linguini1/pygmy/ground-station/enclosure/assembly.FCStd

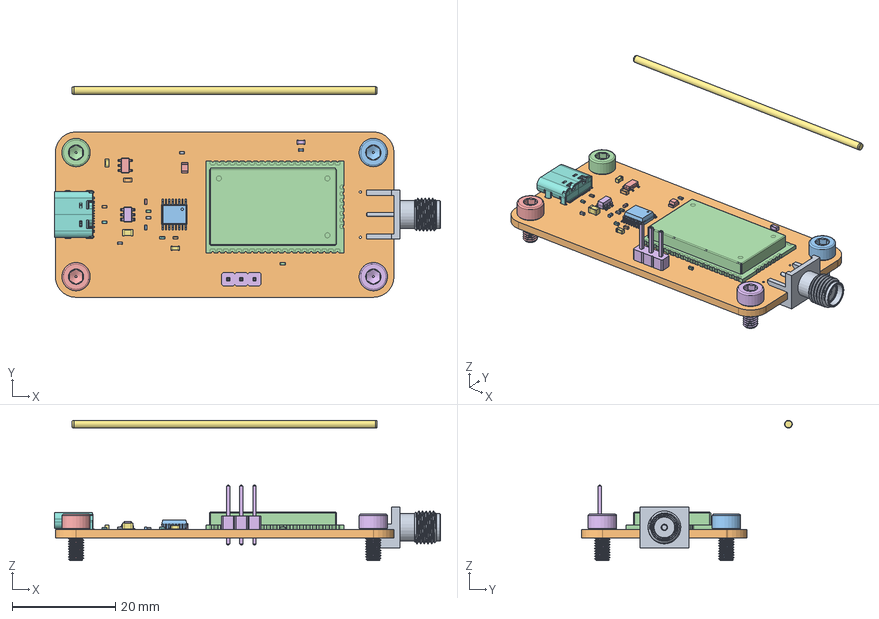
[picture p9: CAD file, 2025-03-23]
ground-station/enclosure/assembly.FCStd
74.7 x 40.7 x 27.1 mm
R_0402_1005Metric
C_0402_1005Metric
C_0402_1005Metric002
C_0402_1005Metric004
TSOT_23_5
C_0603_1608Metric
C_0603_1608Metric002
C_0402_1005Metric006
R_0402_1005Metric002
R_0402_1005Metric004
C_0402_1005Metric008
RN2483-I_RM095
LED_0805_2012Metric
PinHeader_1x03_P254mm_Vertical
C_0603_1608Metric004
R_0402_1005Metric006
SMA_Molex_73251-1153_EdgeMount_Horizontal
C_0603_1608Metric006
SSOP_16_39x49mm_P0635mm
R_0402_1005Metric008
C_0402_1005Metric010
SOT_23_6
L_0805_2012Metric
USB_C_Receptacle_16P_TopMnt_Horizontal_GCT_USB4105-xx-A
C_0402_1005Metric012
ground-station_PCB
M3x6-Screw
M3x6-Screw012
M3x6-Screw013
M3x6-Screw014
1.5 mmx59-Pin
