linguini1/pygmy/flight-computer/enclosure/assembly.FCStd

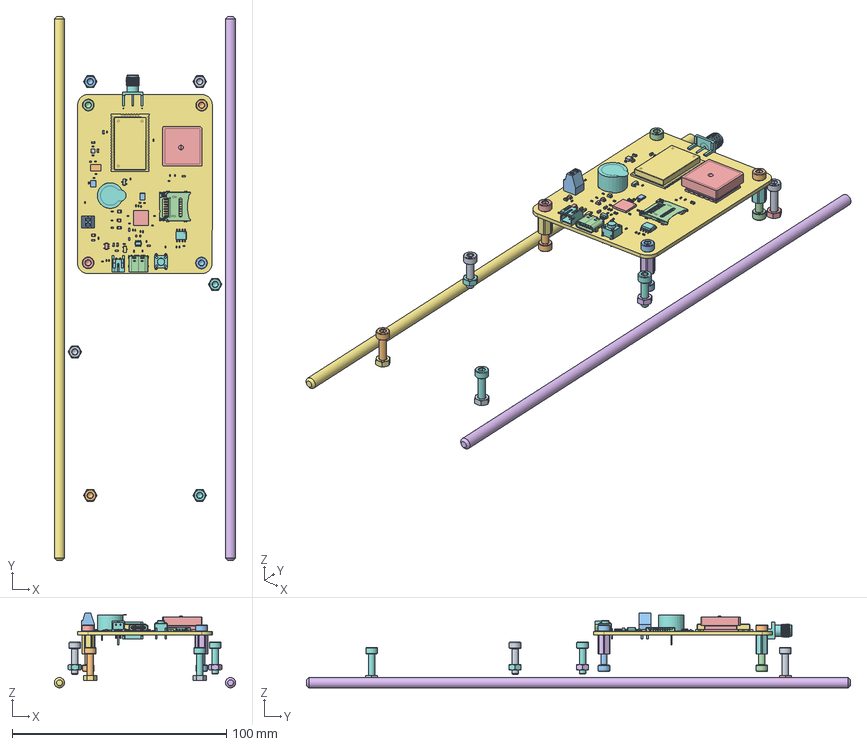
[picture p10: CAD file, 2025-01-09]
flight-computer/enclosure/assembly.FCStd
84.7 x 254.0 x 34.9 mm
C_0603_1608Metric
LED_0805_2012Metric
R_0402_1005Metric
C_0402_1005Metric
LC86G
C_0603_1608Metric002
C_0402_1005Metric002
SMA_Molex_73251-1153_EdgeMount_Horizontal
R_0402_1005Metric002
R_0402_1005Metric004
R_0402_1005Metric006
C_0402_1005Metric004
LED_0805_2012Metric002
C_0402_1005Metric006
SOT-23-3
C_0402_1005Metric008
R_0402_1005Metric008
C_0402_1005Metric010
C_0402_1005Metric012
C_0402_1005Metric014
C_0402_1005Metric016
C_0402_1005Metric018
C_0402_1005Metric020
JST_S2B_PH_K
C_0402_1005Metric022
C_0603_1608Metric004
LSM6DSO32TR
USB_C_Receptacle_16P_TopMnt_Horizontal_GCT_USB4105-xx-A
R_0402_1005Metric010
C_0603_1608Metric006
RN2483-I_RM095
C_0603_1608Metric008
R_0402_1005Metric012
C_0402_1005Metric024
C_0402_1005Metric026
LED_0805_2012Metric004
TSOT_23_5
C_0402_1005Metric028
C_0603_1608Metric010
SOIC_8_39x49mm_P127mm
R_0402_1005Metric014
C_0402_1005Metric030
C_0402_1005Metric032
MEM2067-02-180-00-A
QFN_56_1EP_7x7mm_P04mm_EP32x32mm
LED_0805_2012Metric006
R_0402_1005Metric016
R_0402_1005Metric018
LGA_12_2x2mm_P05mm
R_0402_1005Metric020
R_0402_1005Metric022
C_0402_1005Metric034
C_0603_1608Metric012
R_0402_1005Metric024
R_0402_1005Metric026
SOT_23_6
C_0603_1608Metric014
R_0402_1005Metric028
C_0603_1608Metric016
C_0603_1608Metric018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
