linguini1/pygmy/flight-computer/buzzer/AI-1223-TWT-3V-2-R.step

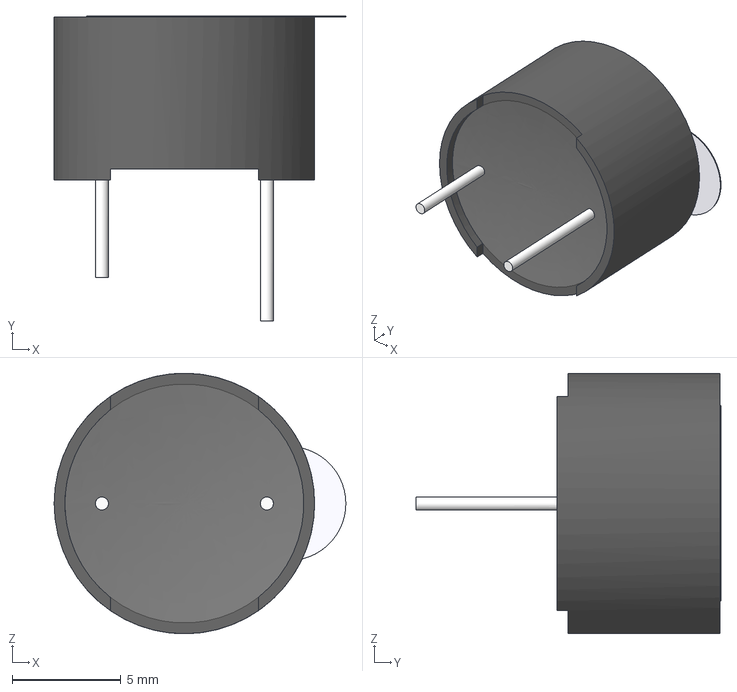
[picture p11: CAD file, 2024-11-21]
flight-computer/buzzer/AI-1223-TWT-3V-2-R.step
13.4 x 14.1 x 12.0 mm
