linguini1/pygmy/flight-computer/enclosure/enclosure.FCStd

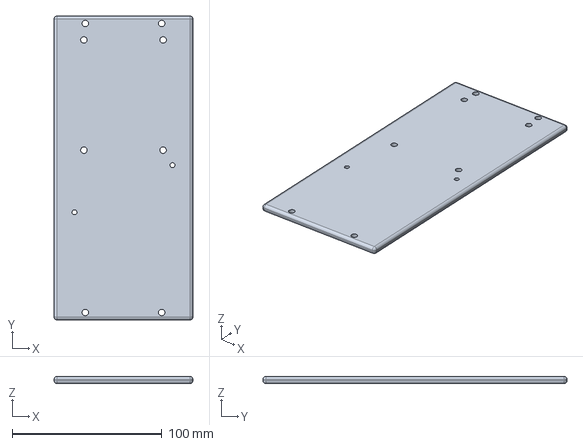
[picture p12: CAD file, 2025-01-09]
flight-computer/enclosure/enclosure.FCStd
92.7 x 203.2 x 5.00 mm
