linguini1/pygmy/flight-computer/lsm6dso32/LSM6DSO32TR.step

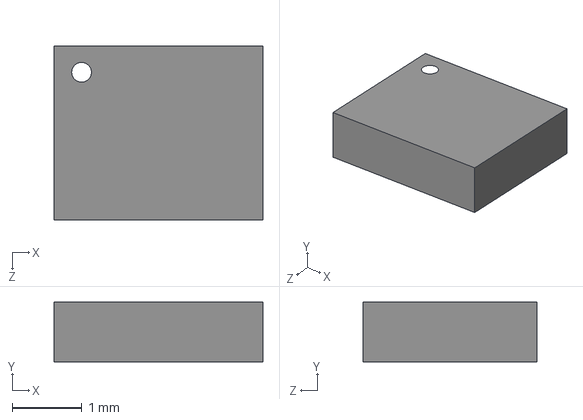
[picture p13: CAD file, 2024-11-11]
flight-computer/lsm6dso32/LSM6DSO32TR.step
3.00 x 0.86 x 2.50 mm
