linguini1/pygmy/flight-computer/microsd/MEM2067-02-180-00-A_REVB.step

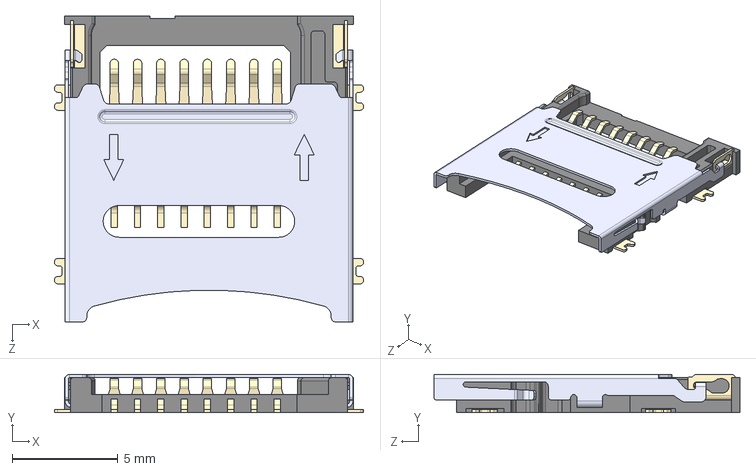
[picture p14: CAD file, 2024-11-11]
flight-computer/microsd/MEM2067-02-180-00-A_REVB.step
14.6 x 1.80 x 14.5 mm
