linguini1/pygmy/ground-station/enclosure/enclosure.FCStd

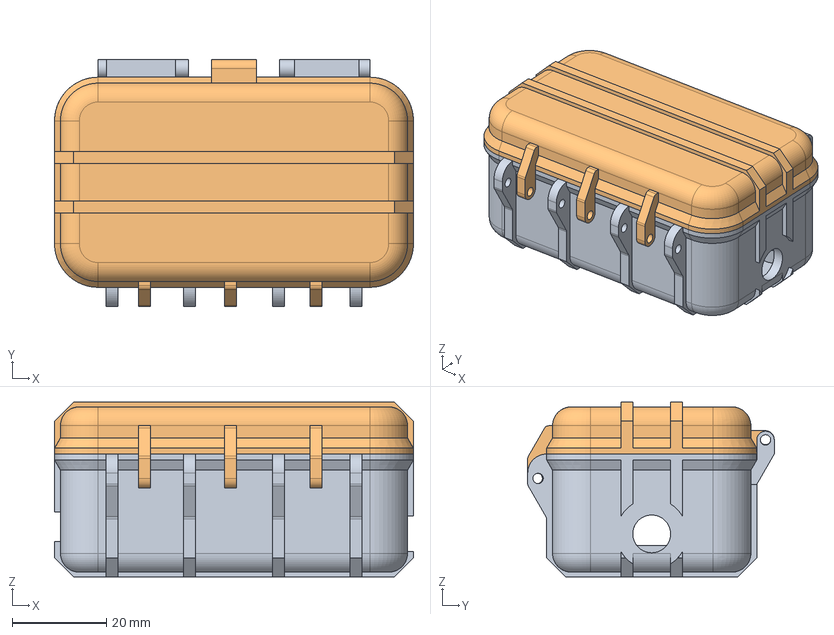
[picture p15: CAD file, 2025-03-23]
ground-station/enclosure/enclosure.FCStd
76.0 x 52.2 x 37.0 mm
Bottom
Top
