linguini1/pygmy/ground-station/enclosure/ground-station.step

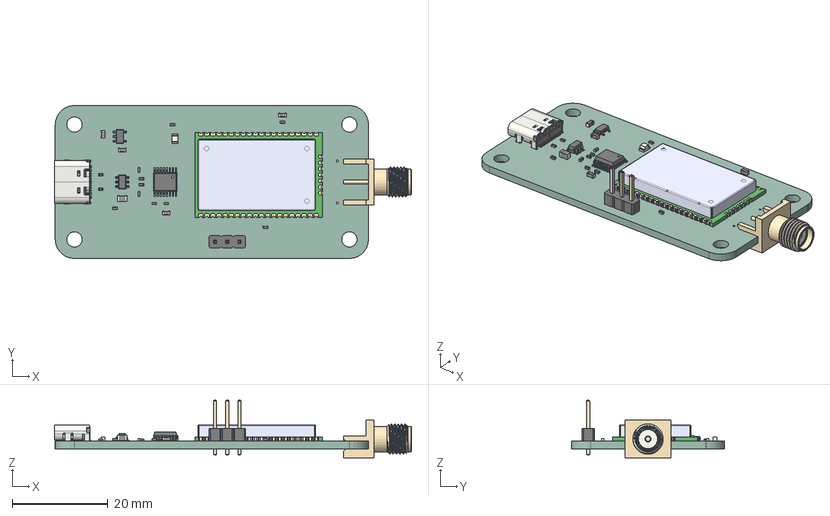
[picture p16: CAD file, 2025-01-08]
ground-station/enclosure/ground-station.step
74.7 x 32.0 x 12.1 mm
R_0402_1005Metric x 5
C_0402_1005Metric x 7
TSOT_23_5
C_0603_1608Metric x 4
RN2483-I_RM095
LED_0805_2012Metric
PinHeader_1x03_P254mm_Vertical
SMA_Molex_73251-1153_EdgeMount_Horizontal
SSOP_16_39x49mm_P0635mm
SOT_23_6
L_0805_2012Metric
USB_C_Receptacle_16P_TopMnt_Horizontal_GCT_USB4105-xx-A
ground-station_PCB
