linguini1/pygmy/flight-computer/minifit-jr/1726480102.step

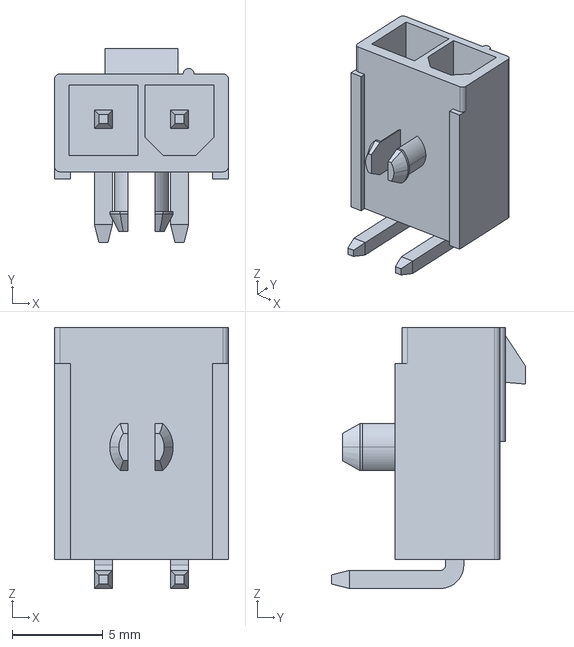
[picture p17: CAD file, 2024-11-11]
flight-computer/minifit-jr/1726480102.step
9.60 x 10.7 x 14.4 mm
