linguini1/pygmy/flight-computer/TODO.txt

Changes:
- More reasonable dimensioning of the board edges, currently slightly weird measurements for hole spacing
- Silkscreen to show direction of IMU & magnetometer axes

Nice to haves:
- Deployment terminal block with MOSFET connection to MCU
