linguini1/pygmy/flight-computer/flight-computer.kicad_pcb

## KiCad design flight-computer/flight-computer.kicad_pcb (2025-01-12)

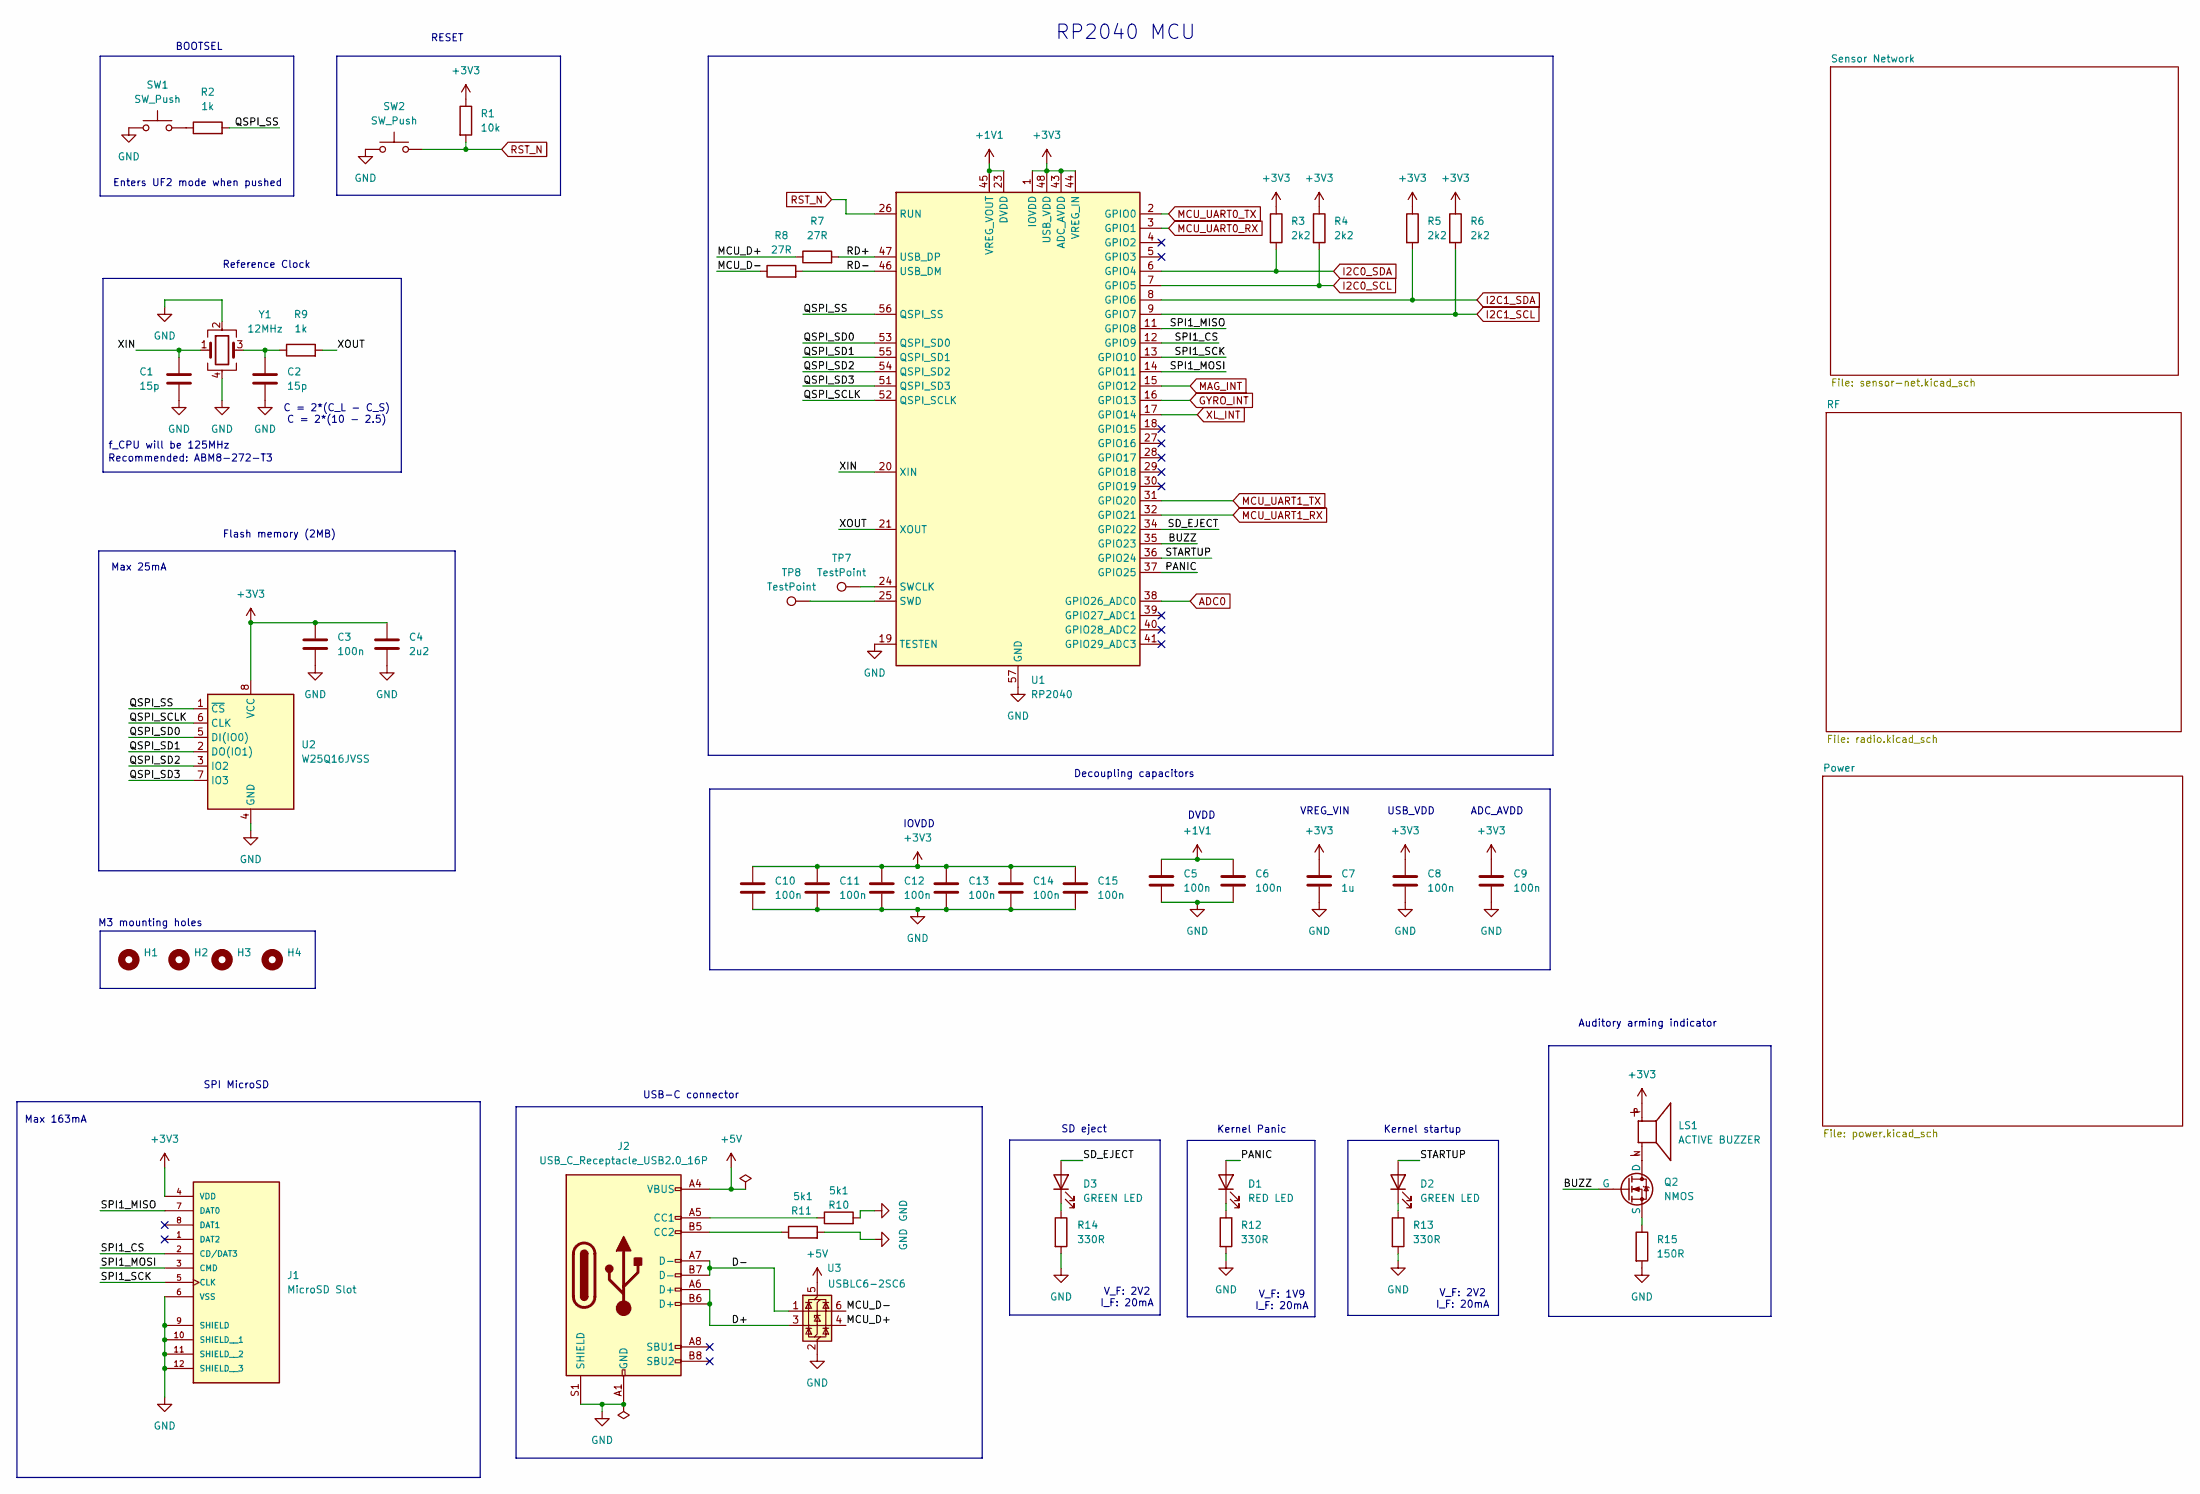
[picture p18: schematic flight-computer.kicad_sch, Pygmy]

Parts:
C1, C2: 15p; C_0402_1005Metric
C3, C5, C6, C8, C9, C10, C11, C12, C13, C14, C15: 100n; C_0402_1005Metric
C4: 2u2; C_0603_1608Metric
C7: 1u; C_0603_1608Metric
D1: RED LED; LED_0805_2012Metric
D2, D3: GREEN LED; LED_0805_2012Metric
H1, H2, H3, H4: MountingHole; MountingHole_3.2mm_M3
J1: MicroSD Slot; GCT_MEM2067-02-180-00-A_REVB
J2: USB_C_Receptacle_USB2.0_16P; USB_C_Receptacle_GCT_USB4105-xx-A_16P_TopMnt_Horizontal
LS1: ACTIVE BUZZER; XDCR_AI-1223-TWT-3V-2-R; PARTREV 3/18/2020
Q2: NMOS; SOT-23-3
R1: 10k; R_0402_1005Metric
R2, R9: 1k; R_0402_1005Metric
R3, R4, R5, R6: 2k2; R_0402_1005Metric
R7, R8: 27R; R_0402_1005Metric
R10, R11: 5k1; R_0402_1005Metric
R12, R13, R14: 330R; R_0402_1005Metric
R15: 150R; R_0402_1005Metric
SW1: SW_Push; SW_PUSH_6mm_H5mm
SW2: SW_Push; SolderJumper-2_P1.3mm_Open_TrianglePad1.0x1.5mm
TP7, TP8: TestPoint; TestPoint_Pad_D1.5mm
U1: RP2040; QFN-56-1EP_7x7mm_P0.4mm_EP3.2x3.2mm
U2: W25Q16JVSS; SOIC-8_5.23x5.23mm_P1.27mm
U3: USBLC6-2SC6; SOT-23-6
Y1: 12MHz; Crystal_SMD_3225-4Pin_3.2x2.5mm

Connections:
+1V1: C5.1, C6.1, U1.23 (DVDD), U1.45 (VREG_VOUT), U1.50 (DVDD)
+3V3: C3.1, C4.1, C7.1, C8.1, C9.1, C10.1, C11.1, C12.1, C13.1, C14.1, C15.1, J1.4 (VDD), LS1.P, R1.1, R3.1, R4.1, R5.1, R6.1, U1.1 (IOVDD), U1.10 (IOVDD), U1.22 (IOVDD), U1.33 (IOVDD), U1.42 (IOVDD), U1.43 (ADC_AVDD), U1.44 (VREG_IN), U1.48 (USB_VDD), U1.49 (IOVDD), U2.8 (VCC); also elsewhere on the board
+5V: J2.A4 (VBUS), J2.A9 (VBUS), J2.B4 (VBUS), J2.B9 (VBUS), U3.5 (VBUS); also elsewhere on the board
/BUZZ: Q2.1 (G), U1.35 (GPIO23)
/D+: J2.A6 (D+), J2.B6 (D+), U3.3 (I/O2)
/D-: J2.A7 (D-), J2.B7 (D-), U3.1 (I/O1)
/MCU_D+: R7.1, U3.4 (I/O2)
/MCU_D-: R8.1, U3.6 (I/O1)
/PANIC: D1.2 (A), U1.37 (GPIO25)
/QSPI_SCLK: U1.52 (QSPI_SCLK), U2.6 (CLK)
/QSPI_SD0: U1.53 (QSPI_SD0), U2.5 (DI(IO0))
/QSPI_SD1: U1.55 (QSPI_SD1), U2.2 (DO(IO1))
/QSPI_SD2: U1.54 (QSPI_SD2), U2.3 (IO2)
/QSPI_SD3: U1.51 (QSPI_SD3), U2.7 (IO3)
/QSPI_SS: R2.2, U1.56 (QSPI_SS), U2.1 (~CS)
/RD+: R7.2, U1.47 (USB_DP)
/RD-: R8.2, U1.46 (USB_DM)
/SD_EJECT: D3.2 (A), U1.34 (GPIO22)
/SPI1_CS: J1.2 (CD/DAT3), U1.12 (GPIO9)
/SPI1_MISO: J1.7 (DAT0), U1.11 (GPIO8)
/SPI1_MOSI: J1.3 (CMD), U1.14 (GPIO11)
/SPI1_SCK: J1.5 (CLK), U1.13 (GPIO10)
/STARTUP: D2.2 (A), U1.36 (GPIO24)
/XIN: C1.1, U1.20 (XIN), Y1.1
/XOUT: R9.2, U1.21 (XOUT)
ADC0: U1.38 (GPIO26_ADC0); also elsewhere on the board
GND: C1.2, C2.2, C3.2, C4.2, C5.2, C6.2, C7.2, C8.2, C9.2, C10.2, C11.2, C12.2, C13.2, C14.2, C15.2, J1.6 (VSS), J1.9 (SHIELD), J1.10 (SHIELD__1), J1.11 (SHIELD__2), J1.12 (SHIELD__3), J2.A1 (GND), J2.A12 (GND), J2.B1 (GND), J2.B12 (GND), J2.S1 (SHIELD), R10.2, R11.2, R12.2, R13.2, R14.2, R15.2, SW1.1, SW2.1, U1.19 (TESTEN), U1.57 (GND), U2.4 (GND), U3.2 (GND), Y1.2, Y1.4; also elsewhere on the board
GYRO_INT: U1.16 (GPIO13); also elsewhere on the board
I2C0_SCL: R4.2, U1.7 (GPIO5); also elsewhere on the board
I2C0_SDA: R3.2, U1.6 (GPIO4); also elsewhere on the board
I2C1_SCL: R6.2, U1.9 (GPIO7); also elsewhere on the board
I2C1_SDA: R5.2, U1.8 (GPIO6); also elsewhere on the board
MAG_INT: U1.15 (GPIO12); also elsewhere on the board
MCU_UART0_RX: U1.3 (GPIO1); also elsewhere on the board
MCU_UART0_TX: U1.2 (GPIO0); also elsewhere on the board
MCU_UART1_RX: U1.32 (GPIO21); also elsewhere on the board
MCU_UART1_TX: U1.31 (GPIO20); also elsewhere on the board
unnamed: C2.1, R9.1, Y1.3
unnamed: D1.1 (K), R12.1
unnamed: D2.1 (K), R13.1
unnamed: D3.1 (K), R14.1
unnamed: J2.A5 (CC1), R10.1
unnamed: J2.B5 (CC2), R11.1
unnamed: LS1.N, Q2.3 (D)
unnamed: Q2.2 (S), R15.1
unnamed: R2.1, SW1.2
unnamed 54: TP7.1, U1.24 (SWCLK); also elsewhere on the board
unnamed 55: TP8.1, U1.25 (SWD); also elsewhere on the board
RST_N: R1.2, SW2.2, U1.26 (RUN); also elsewhere on the board
XL_INT: U1.17 (GPIO14); also elsewhere on the board

Notes on the sheet:
Auditory arming indicator
RP2040 MCU
C = 2*(C_L - C_S) C = 2*(10 - 2.5)
Kernel Panic
Kernel startup
V_F: 2V2 I_F: 20mA
VREG_VIN
USB_VDD
Recommended: ABM8-272-T3
Max 163mA
DVDD
M3 mounting holes
IOVDD
SPI MicroSD
USB-C connector
f_CPU will be 125MHz
V_F: 1V9 I_F: 20mA
Decoupling capacitors
BOOTSEL
Reference Clock
ADC_AVDD
RESET
Flash memory (2MB)
Max 25mA
Enters UF2 mode when pushed
SD eject

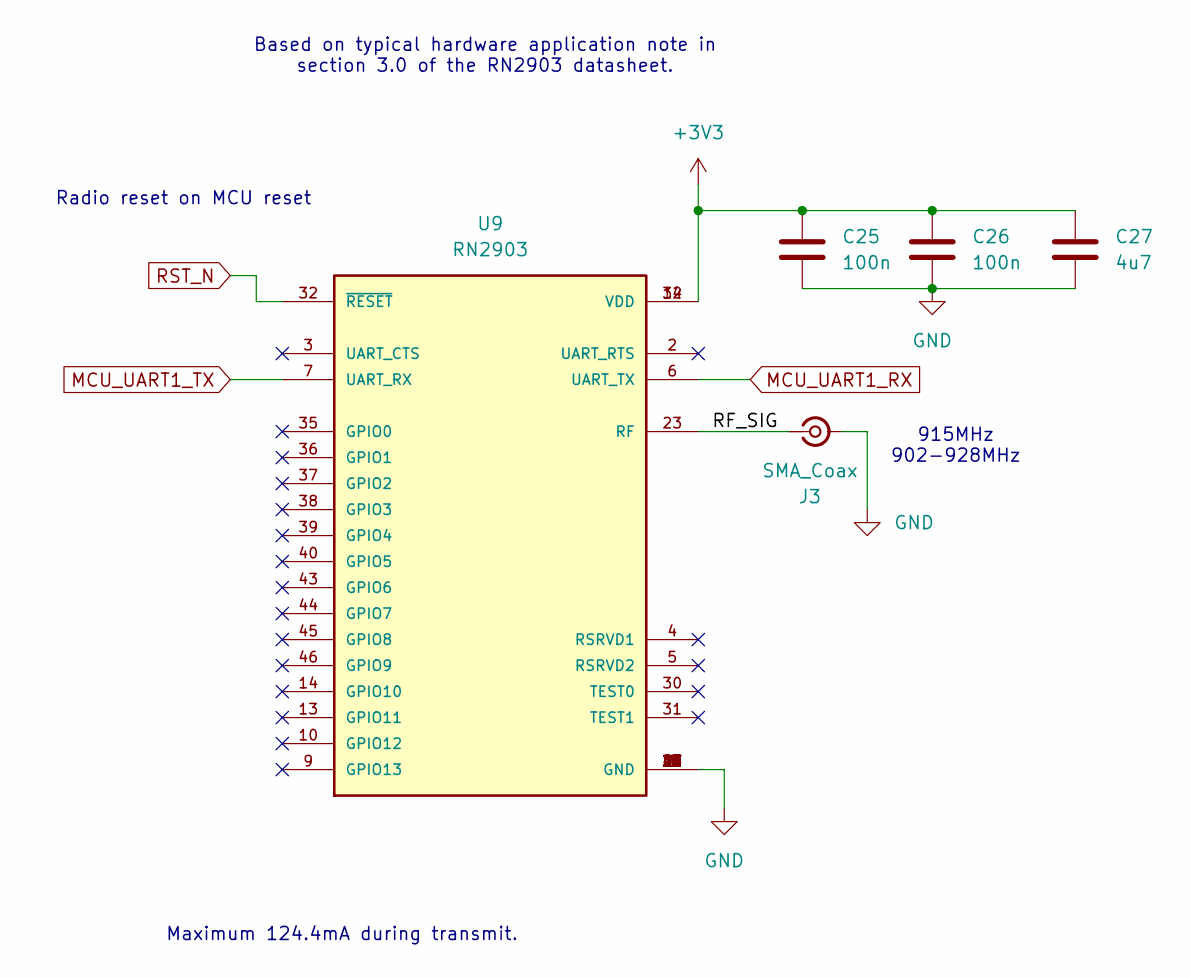
[picture p19: schematic radio.kicad_sch, Pygmy]

Parts:
C25, C26: 100n; C_0402_1005Metric
C27: 4u7; C_0603_1608Metric
J3: SMA_Coax; SMA_Molex_73251-1153_EdgeMount_Horizontal
U9: RN2903

Connections:
+3V3: C25.1, C26.1, C27.1, U9.12 (VDD), U9.34 (VDD); also elsewhere on the board
/RF/RF_SIG: J3.1 (In), U9.23 (RF)
GND: C25.2, C26.2, C27.2, J3.2 (Ext), U9.1 (GND), U9.8 (GND), U9.11 (GND), U9.20 (GND), U9.21 (GND), U9.22 (GND), U9.24 (GND), U9.26 (GND), U9.27 (GND), U9.28 (GND), U9.33 (GND), U9.41 (GND), U9.47 (GND); also elsewhere on the board
MCU_UART1_RX: U9.6 (UART_TX); also elsewhere on the board
MCU_UART1_TX: U9.7 (UART_RX); also elsewhere on the board
RST_N: U9.32 (~RESET); also elsewhere on the board

Notes on the sheet:
915MHz 902-928MHz
Radio reset on MCU reset
Maximum 124.4mA during transmit.
Based on typical hardware application note in section 3.0 of the RN2903 datasheet.

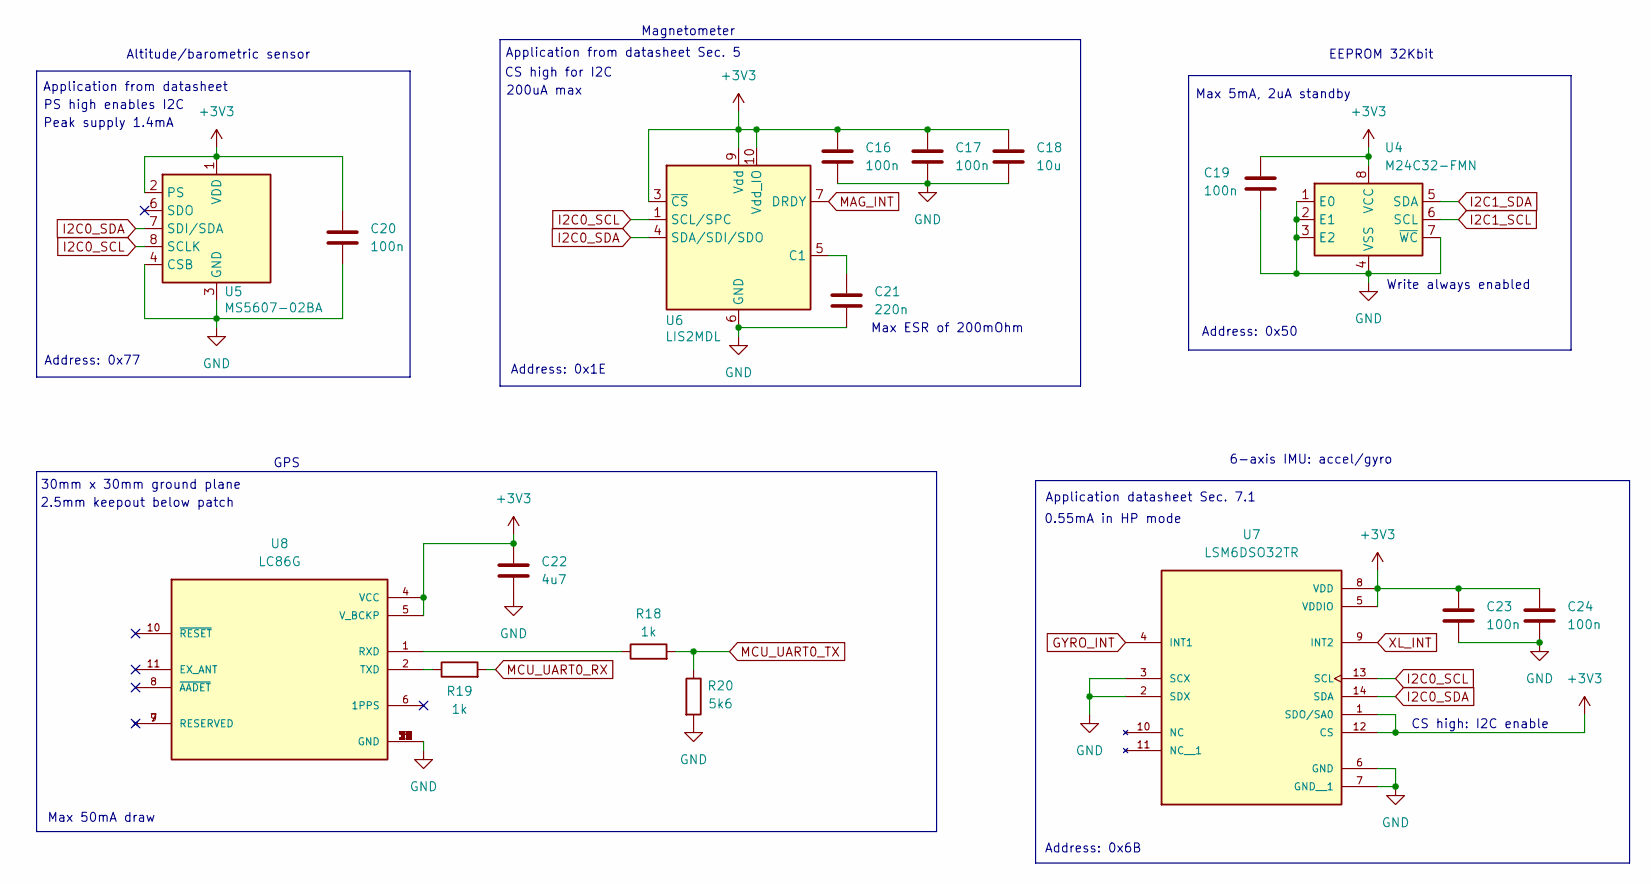
[picture p20: schematic sensor-net.kicad_sch, Pygmy]

Parts:
C16, C17, C19, C20, C23, C24: 100n; C_0402_1005Metric
C18: 10u; C_0603_1608Metric
C21: 220n; C_0603_1608Metric
C22: 4u7; C_0603_1608Metric
R18, R19: 1k; R_0402_1005Metric
R20: 5k6; R_0402_1005Metric
U4: M24C32-FMN; SOIC-8_3.9x4.9mm_P1.27mm
U5: MS5607-02BA; LGA-8_3x5mm_P1.25mm
U6: LIS2MDL; LGA-12_2x2mm_P0.5mm
U7: LSM6DSO32TR; XDCR_LSM6DSO32TR
U8: LC86G; XCVR_LC86G

Connections:
+3V3: C16.1, C17.1, C18.1, C19.1, C20.1, C22.1, C23.1, C24.1, U4.8 (VCC), U5.1 (VDD), U5.2 (PS), U6.3 (~CS), U6.9 (Vdd), U6.10 (Vdd_IO), U7.1 (SDO/SA0), U7.5 (VDDIO), U7.8 (VDD), U7.12 (CS), U8.4 (VCC), U8.5 (V_BCKP); also elsewhere on the board
GND: C16.2, C17.2, C18.2, C19.2, C20.2, C21.2, C22.2, C23.2, C24.2, R20.2, U4.1 (E0), U4.2 (E1), U4.3 (E2), U4.4 (VSS), U4.7 (~WC), U5.3 (GND), U5.4 (CSB), U5.5 (CSB), U6.6 (GND), U6.8 (GND), U7.2 (SDX), U7.3 (SCX), U7.6 (GND), U7.7 (GND__1), U8.3 (GND), U8.12 (GND), U8.13 (GND), U8.14 (GND), U8.15 (GND), U8.16 (GND), U8.17 (GND), U8.18 (GND), U8.19 (GND), U8.20 (GND), U8.21 (GND), U8.22 (GND), U8.23 (GND), U8.24 (GND), U8.25 (GND), U8.26 (GND), U8.27 (GND), U8.28 (GND), U8.29 (GND), U8.30 (GND), U8.31 (GND), U8.32 (GND), U8.33 (GND), U8.34 (GND), U8.35 (GND), U8.36 (GND); also elsewhere on the board
GYRO_INT: U7.4 (INT1); also elsewhere on the board
I2C0_SCL: U5.8 (SCLK), U6.1 (SCL/SPC), U7.13 (SCL); also elsewhere on the board
I2C0_SDA: U5.7 (SDI/SDA), U6.4 (SDA/SDI/SDO), U7.14 (SDA); also elsewhere on the board
I2C1_SCL: U4.6 (SCL); also elsewhere on the board
I2C1_SDA: U4.5 (SDA); also elsewhere on the board
MAG_INT: U6.7 (DRDY); also elsewhere on the board
MCU_UART0_RX: R19.2; also elsewhere on the board
MCU_UART0_TX: R18.2, R20.1; also elsewhere on the board
unnamed: C21.1, U6.5 (C1)
unnamed: R18.1, U8.1 (RXD)
unnamed: R19.1, U8.2 (TXD)
XL_INT: U7.9 (INT2); also elsewhere on the board

Notes on the sheet:
Application datasheet Sec. 7.1
CS high for I2C
Address: 0x50
Address: 0x6B
Application from datasheet Sec. 5
Address: 0x77
30mm x 30mm ground plane
Altitude/barometric sensor
Max 5mA, 2uA standby
GPS
6-axis IMU: accel/gyro
200uA max
Magnetometer
Address: 0x1E
EEPROM 32Kbit
CS high: I2C enable
Write always enabled
PS high enables I2C
Application from datasheet
Peak supply 1.4mA
2.5mm keepout below patch
Max 50mA draw
0.55mA in HP mode
Max ESR of 200mOhm

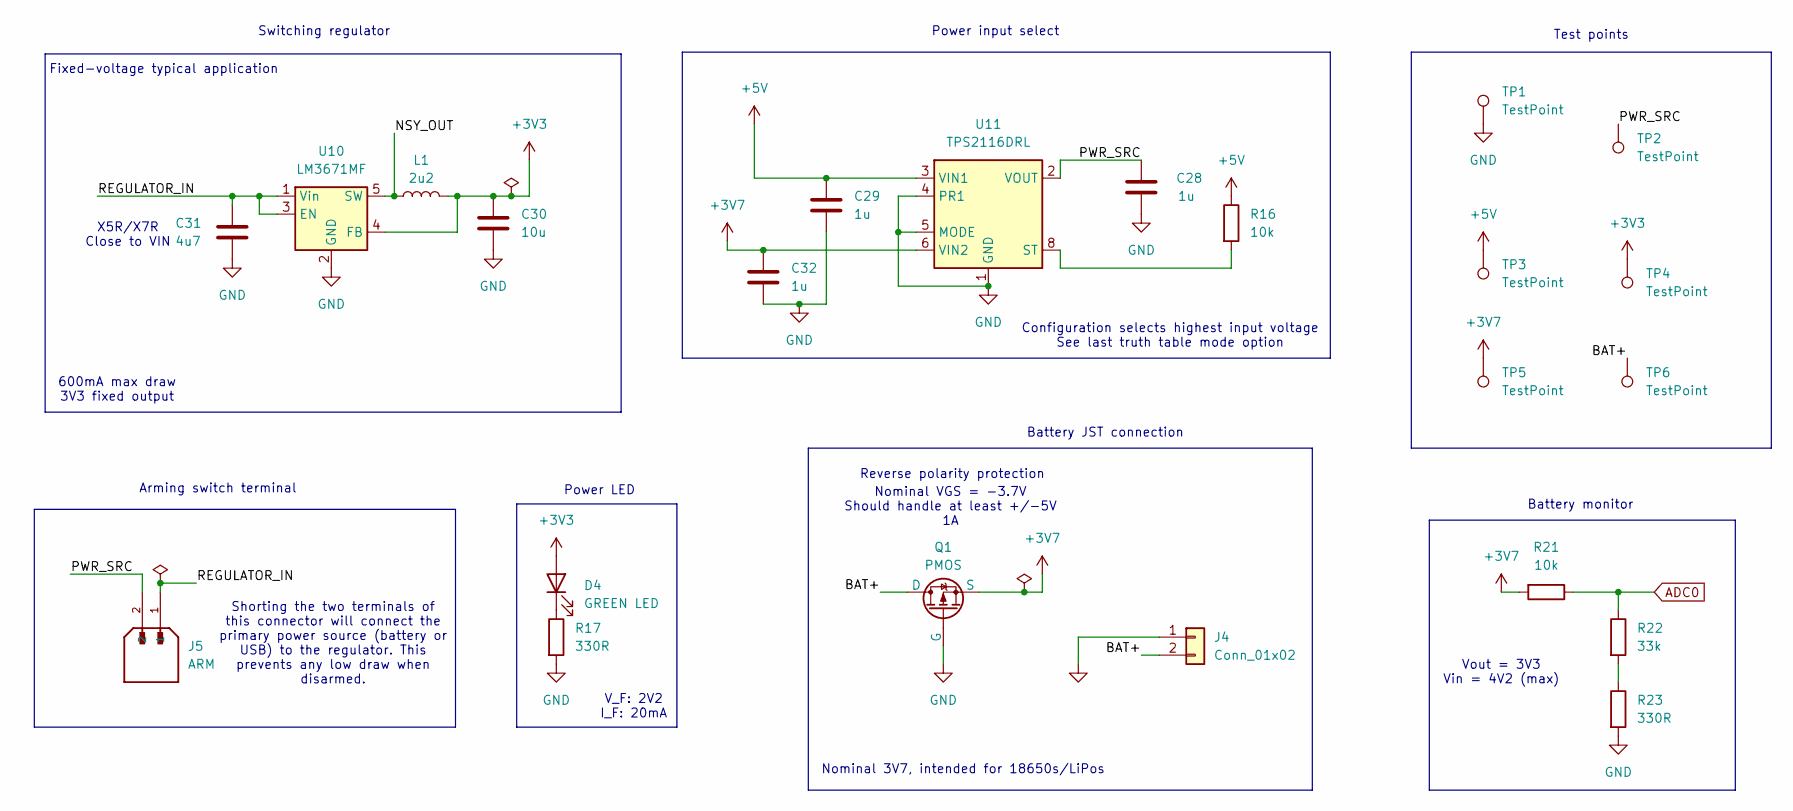
[picture p21: schematic power.kicad_sch, Pygmy]

Parts:
C28, C29, C32: 1u; C_0603_1608Metric
C30: 10u; C_0603_1608Metric
C31: 4u7; C_0603_1608Metric
D4: GREEN LED; LED_0805_2012Metric
J4: Conn_01x02; JST_PH_S2B-PH-K_1x02_P2.00mm_Horizontal
J5: ARM; TerminalBlock_Phoenix_MPT-0,5-2-2.54_1x02_P2.54mm_Horizontal; PARTREV A2
L1: 2u2; LPO3310222MLC
Q1: PMOS; SOT-23-3
R16, R21: 10k; R_0402_1005Metric
R17, R23: 330R; R_0402_1005Metric
R22: 33k; R_0402_1005Metric
TP1, TP2, TP4, TP5, TP6: TestPoint; TestPoint_Pad_D1.5mm
TP3: TestPoint; TestPoint_Pad_D1.0mm
U10: LM3671MF; TSOT-23-5
U11: TPS2116DRL; SOT-583-8

Connections:
+3V3: C30.1, D4.2 (A), L1.2, TP4.1, U10.4 (FB); also elsewhere on the board
+3V7: C32.1, Q1.2 (S), R21.2, TP5.1, U11.6 (VIN2); also elsewhere on the board
+5V: C29.1, R16.1, TP3.1, U11.3 (VIN1); also elsewhere on the board
/Power/BAT+: J4.2, Q1.3 (D), TP6.1; also elsewhere on the board
/Power/NSY_OUT: L1.1, U10.5 (SW)
/Power/PWR_SRC: C28.1, J5.2, TP2.1, U11.2 (VOUT), U11.7 (VOUT); also elsewhere on the board
/Power/REGULATOR_IN: C31.1, J5.1, U10.1 (Vin), U10.3 (EN)
ADC0: R21.1, R22.1; also elsewhere on the board
GND: C28.2, C29.2, C30.2, C31.2, C32.2, J4.1, Q1.1 (G), R17.2, R23.2, TP1.1, U10.2 (GND), U11.1 (GND), U11.4 (PR1), U11.5 (MODE); also elsewhere on the board
unnamed: D4.1 (K), R17.1
unnamed: R22.2, R23.1
unnamed: R16.2, U11.8 (ST)

Notes on the sheet:
Arming switch terminal
V_F: 2V2 I_F: 20mA
Switching regulator
Nominal VGS = -3.7V Should handle at least +/-5V 1A
Configuration selects highest input voltage See last truth table mode option
Vout = 3V3 Vin = 4V2 (max)
Shorting the two terminals of this connector will connect the primary power source (battery or USB) to the regulator. This prevents any low draw when disarmed.
600mA max draw 3V3 fixed output
Nominal 3V7, intended for 18650s/LiPos
Fixed-voltage typical application
Test points
Power input select
X5R/X7R Close to VIN
Battery JST connection
Power LED
Reverse polarity protection
Battery monitor

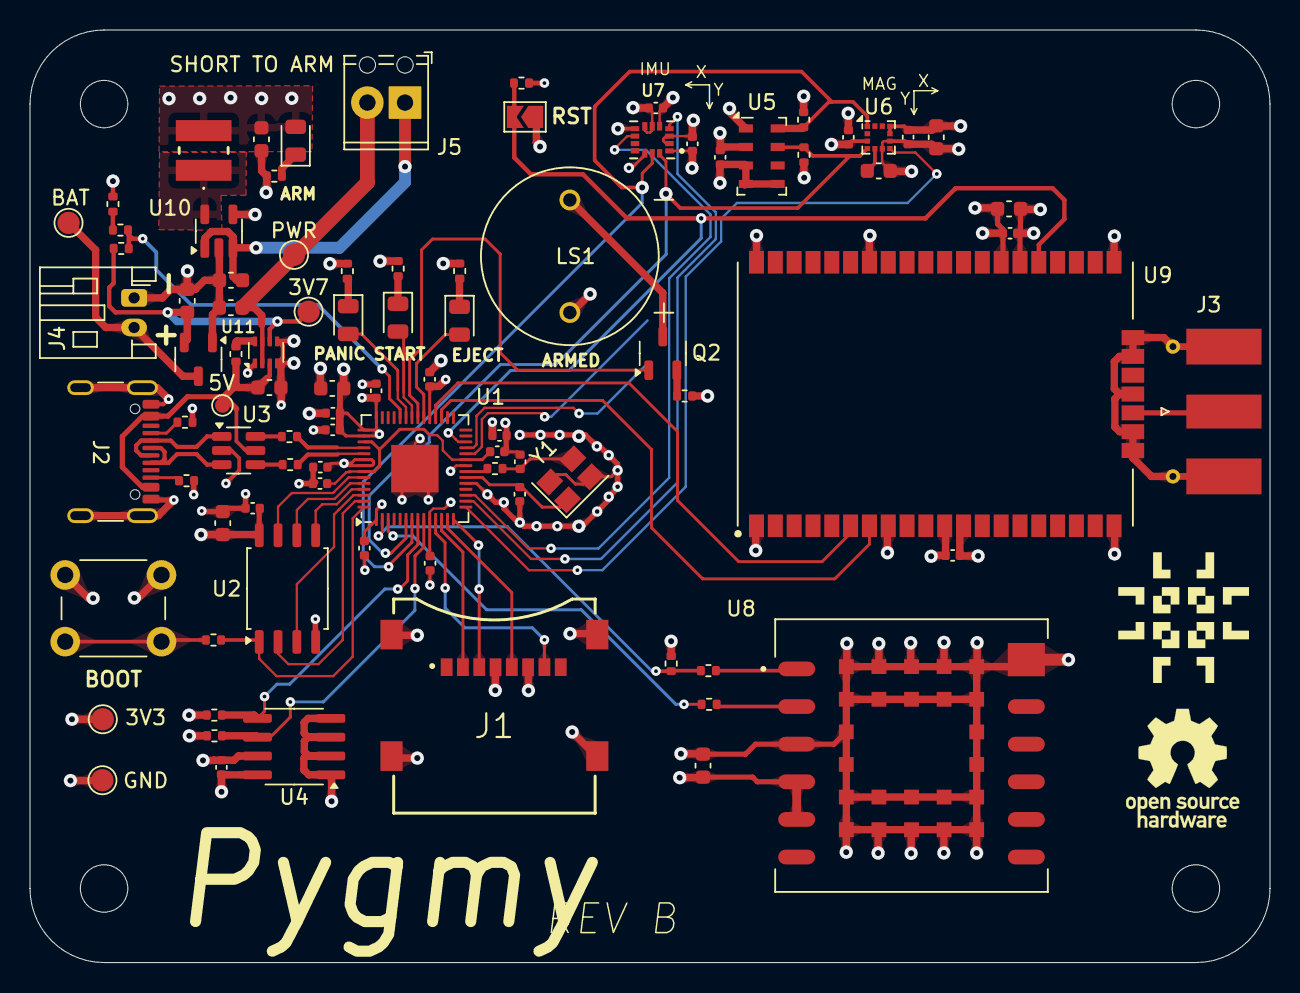
[picture p22: board flight-computer.kicad_pcb from above]

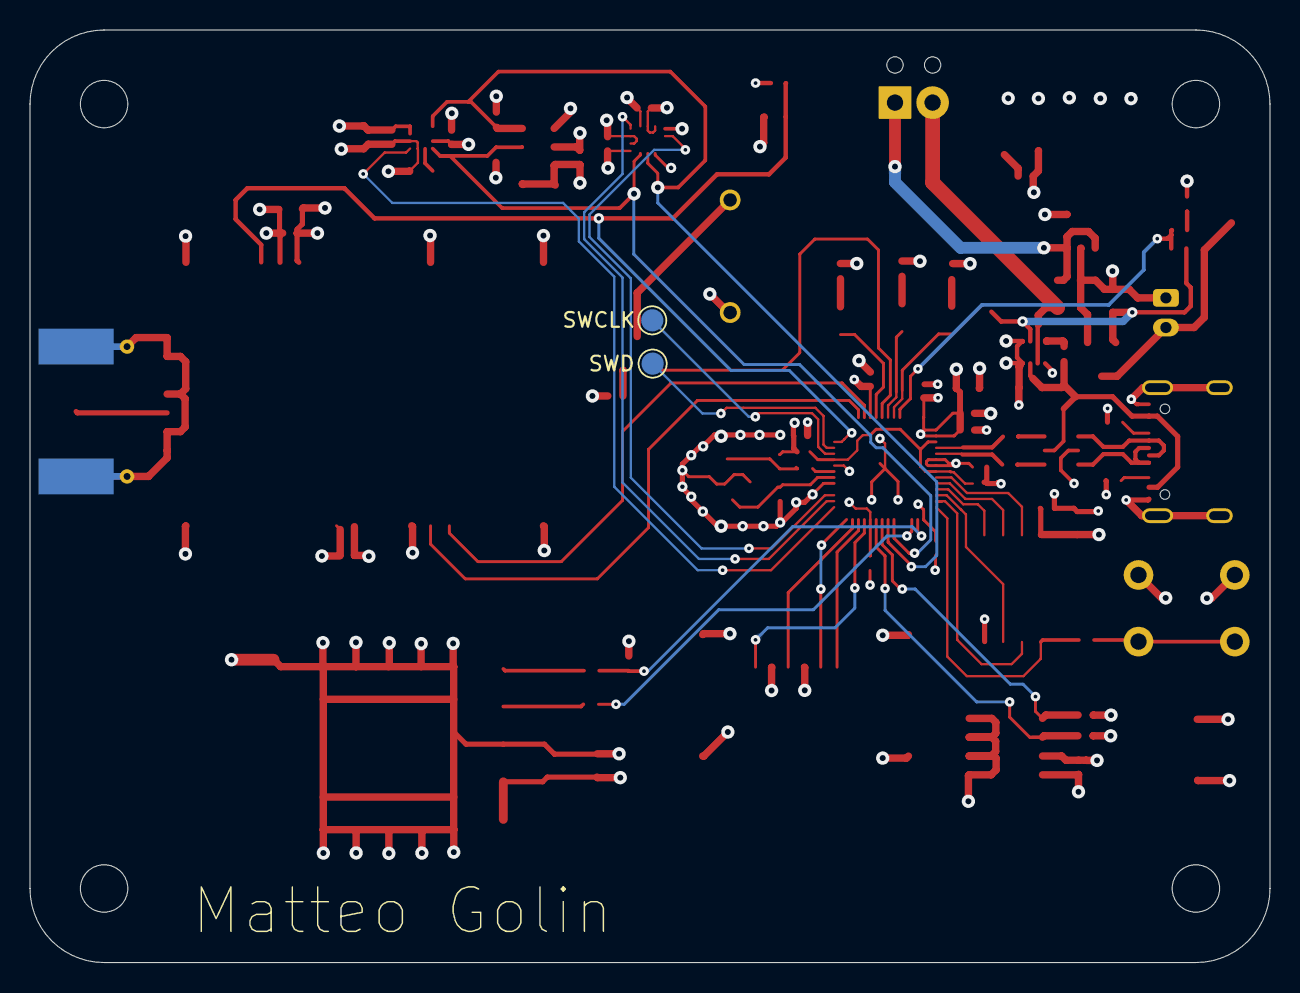
[picture p23: board flight-computer.kicad_pcb from below]

Board: 4 copper layers, 83.7 x 62.9 mm, 94 parts (2 on the bottom side), 62 nets.

Other parts of the board:
3V3, 3V7: TestPoint; TestPoint_Pad_D1.5mm
5V: TestPoint; TestPoint_Pad_D1.0mm
BAT: TestPoint; TestPoint_Pad_D1.5mm
GND: TestPoint; TestPoint_Pad_D1.5mm
PWR: TestPoint; TestPoint_Pad_D1.5mm
SWCLK: TestPoint; TestPoint_Pad_D1.5mm
SWD: TestPoint; TestPoint_Pad_D1.5mm

Their connections:
+3V3: 3V3.1; also elsewhere on the board
+3V7: 3V7.1; also elsewhere on the board
+5V: 5V.1; also elsewhere on the board
/Power/BAT+: BAT.1; also elsewhere on the board
/Power/PWR_SRC: PWR.1; also elsewhere on the board
GND: GND.1; also elsewhere on the board
unnamed 54: SWCLK.1; also elsewhere on the board
unnamed 55: SWD.1; also elsewhere on the board
