linguini1/pygmy/ground-station/ground-station.kicad_pcb

## KiCad design ground-station/ground-station.kicad_pcb (2025-01-04)

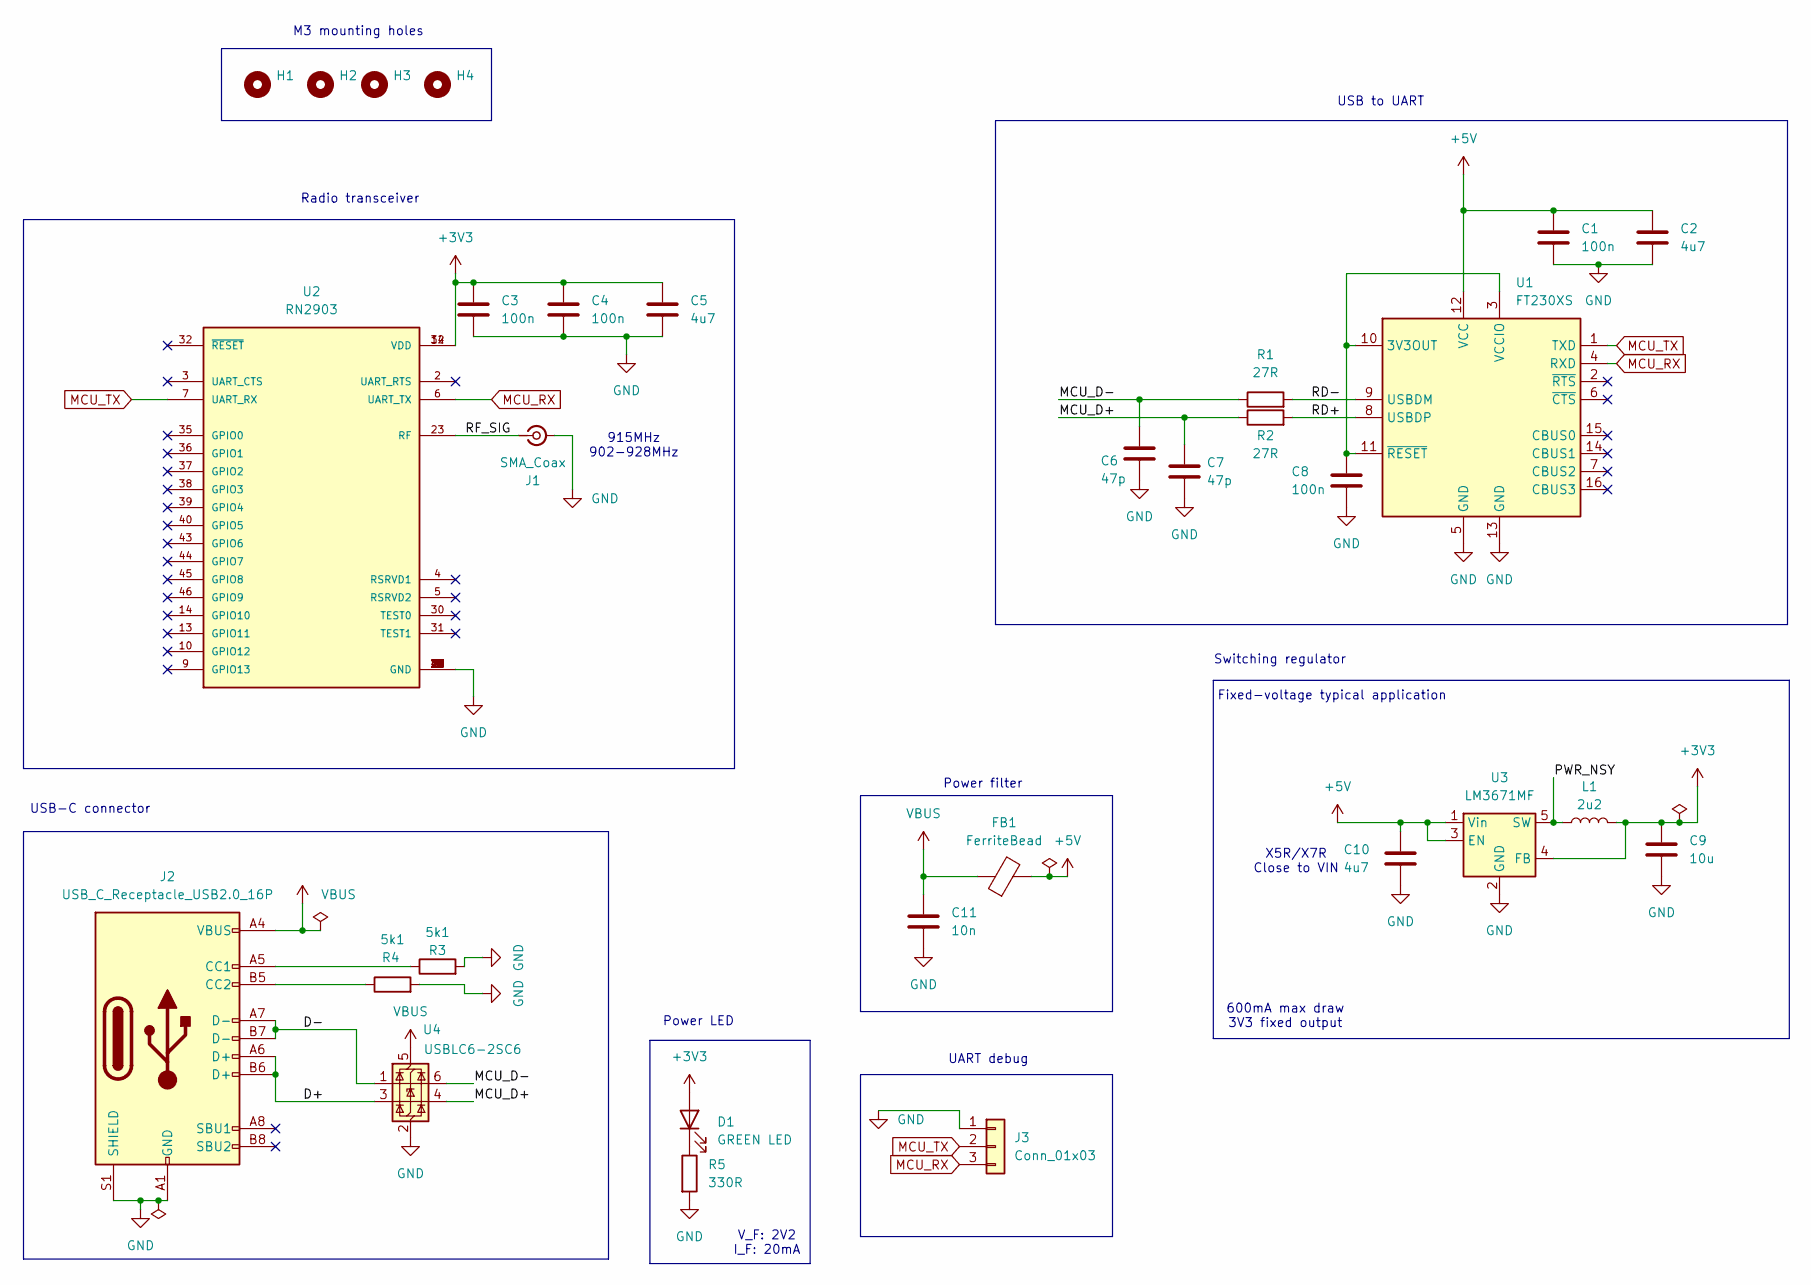
[picture p24: schematic ground-station.kicad_sch, Pygmy Ground Station]

Parts:
C1, C3, C4, C8: 100n; C_0402_1005Metric
C2, C5, C10: 4u7; C_0603_1608Metric
C6, C7: 47p; C_0402_1005Metric
C9: 10u; C_0603_1608Metric
C11: 10n; C_0402_1005Metric
D1: GREEN LED; LED_0805_2012Metric
FB1: FerriteBead; L_0805_2012Metric
H1, H2, H3, H4: MountingHole; MountingHole_3.2mm_M3
J1: SMA_Coax; SMA_Molex_73251-1153_EdgeMount_Horizontal
J2: USB_C_Receptacle_USB2.0_16P; USB_C_Receptacle_GCT_USB4105-xx-A_16P_TopMnt_Horizontal
J3: Conn_01x03; PinHeader_1x03_P2.54mm_Vertical
L1: 2u2; LPO3310222MLC
R1, R2: 27R; R_0402_1005Metric
R3, R4: 5k1; R_0402_1005Metric
R5: 330R; R_0402_1005Metric
U1: FT230XS; SSOP-16_3.9x4.9mm_P0.635mm
U2: RN2903
U3: LM3671MF; TSOT-23-5
U4: USBLC6-2SC6; SOT-23-6

Connections:
+3V3: C3.1, C4.1, C5.1, C9.1, D1.2 (A), L1.2, U2.12 (VDD), U2.34 (VDD), U3.4 (FB)
+5V: C1.1, C2.1, C10.1, FB1.2, U1.12 (VCC), U3.1 (Vin), U3.3 (EN)
/D+: J2.A6 (D+), J2.B6 (D+), U4.3 (I/O2)
/D-: J2.A7 (D-), J2.B7 (D-), U4.1 (I/O1)
/MCU_D+: C7.1, R2.1, U4.4 (I/O2)
/MCU_D-: C6.1, R1.1, U4.6 (I/O1)
/PWR_NSY: L1.1, U3.5 (SW)
/RD+: R2.2, U1.8 (USBDP)
/RD-: R1.2, U1.9 (USBDM)
/RF_SIG: J1.1 (In), U2.23 (RF)
GND: C1.2, C2.2, C3.2, C4.2, C5.2, C6.2, C7.2, C8.2, C9.2, C10.2, C11.2, J1.2 (Ext), J2.A1 (GND), J2.A12 (GND), J2.B1 (GND), J2.B12 (GND), J2.S1 (SHIELD), J3.1, R3.2, R4.2, R5.2, U1.5 (GND), U1.13 (GND), U2.1 (GND), U2.8 (GND), U2.11 (GND), U2.20 (GND), U2.21 (GND), U2.22 (GND), U2.24 (GND), U2.26 (GND), U2.27 (GND), U2.28 (GND), U2.33 (GND), U2.41 (GND), U2.47 (GND), U3.2 (GND), U4.2 (GND)
MCU_RX: J3.3, U1.4 (RXD), U2.6 (UART_TX)
MCU_TX: J3.2, U1.1 (TXD), U2.7 (UART_RX)
unnamed: D1.1 (K), R5.1
unnamed: J2.A5 (CC1), R3.1
unnamed: J2.B5 (CC2), R4.1
unnamed: C8.1, U1.3 (VCCIO), U1.10 (3V3OUT), U1.11 (~RESET)
VBUS: C11.1, FB1.1, J2.A4 (VBUS), J2.A9 (VBUS), J2.B4 (VBUS), J2.B9 (VBUS), U4.5 (VBUS)

Notes on the sheet:
V_F: 2V2 I_F: 20mA
UART debug
Switching regulator
Fixed-voltage typical application
USB-C connector
Power LED
Power filter
M3 mounting holes
Radio transceiver
600mA max draw 3V3 fixed output
X5R/X7R Close to VIN
915MHz 902-928MHz
USB to UART

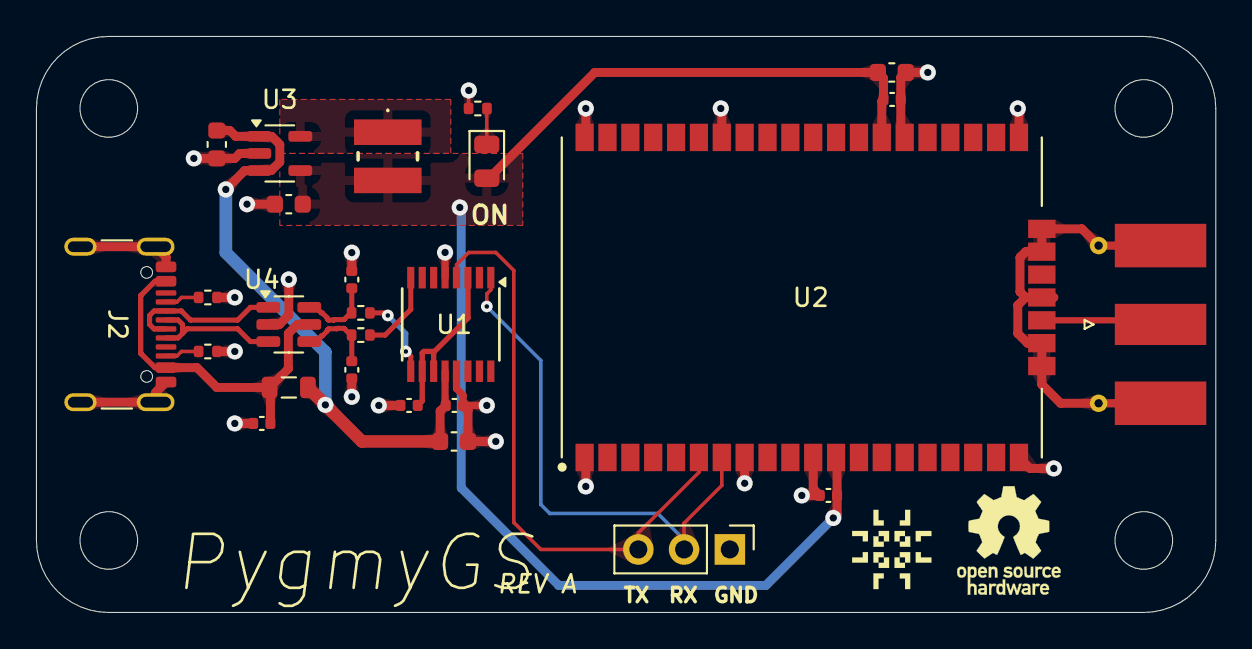
[picture p25: board ground-station.kicad_pcb from above]

Board: 4 copper layers, 65.5 x 32.0 mm, 30 parts (0 on the bottom side), 18 nets.
