linguini1/pygmy/(commit log)

2024-11-11 Initial commit.
    [1726480102.step, LSM6DSO32TR.step, MEM2067-02-180-00-A_REVB.step, RN2483-I_RM095.STEP, RN2483-I_RM095.step, flight-computer.kicad_pcb, flight-computer.kicad_sch, radio.kicad_sch]
2024-11-13 Added power circuitry and status LEDs. Went for an LDO with very low dropout voltage to reduce potential noise from a switching reg.
    [TPS74533PQWDRVRQ1.step, flight-computer.kicad_sch, power.kicad_sch, sensor-net.kicad_sch]
2024-11-13 Add title block
    [power.kicad_sch]
2024-11-21 Added decoupling caps to RN2483 and fixed antenna connection. Also settled on easy GPS.
    [flight-computer.kicad_sch, power.kicad_sch, radio.kicad_sch, sensor-net.kicad_sch]
2024-11-21 Updated power supply to use buck regulator and power input MUX. Also computed current draw of the board to size power regulator.
    [TPS74533PQWDRVRQ1.step, flight-computer.kicad_sch, power.kicad_sch, radio.kicad_sch, sensor-net.kicad_sch]
2024-11-21 Added capacitors to MUX to supply transient power when switching.
    [flight-computer.kicad_sch, power.kicad_sch]
2024-11-21 Added footprints for all components
    [AI-1223-TWT-3V-2-R.step, flight-computer.kicad_sch, power.kicad_sch, radio.kicad_sch, sensor-net.kicad_sch]
2024-11-21 Updated PCB so components are now on there.
    [flight-computer.kicad_pcb, flight-computer.kicad_sch, radio.kicad_sch]
2024-11-27 Remove unnecessary footprints.
    [RN2483-I_RM095.STEP, RN2483-I_RM095.step, flight-computer.kicad_pcb]
2024-11-27 Update radio module to RN2903 for unlicensed band.
    [radio.kicad_sch]
2024-11-27 Update net names.
    [flight-computer.kicad_pcb, radio.kicad_sch]
2024-11-27 Moved around files to make a new documents folder.
    [1726480102.step, AI-1223-TWT-3V-2-R.step, LSM6DSO32TR.step, MEM2067-02-180-00-A_REVB.step, flight-computer.kicad_pcb, flight-computer.kicad_sch, power.kicad_sch, radio.kicad_sch]
2024-11-27 Added current draw to the manual.
2024-11-27 Filled out the BOM for the schematic. Consolidated some components and changed footprint sizes.
    [flight-computer.kicad_pcb, flight-computer.kicad_sch, power.kicad_sch, radio.kicad_sch, sensor-net.kicad_sch]
2024-11-27 Updated inductor footprint.
    [flight-computer.kicad_pcb, power.kicad_sch]
2024-11-27 Initial layout
    [flight-computer.kicad_pcb]
2024-12-27 Updated GPS to L86G
    [flight-computer.kicad_pcb, flight-computer.kicad_sch, sensor-net.kicad_sch]
2024-12-27 Added mounting holes and copper pours.
    [flight-computer.kicad_pcb, flight-computer.kicad_sch, sensor-net.kicad_sch]
2024-12-28 Added reverse polarity protection on JST connector
    [flight-computer.kicad_pcb, flight-computer.kicad_sch, power.kicad_sch]
2024-12-28 Almost done routing
    [flight-computer.kicad_pcb, flight-computer.kicad_sch, power.kicad_sch]
2024-12-28 Added test points and finished routing
    [flight-computer.kicad_pcb, power.kicad_sch]
2024-12-28 Teardrops and some cleanup
    [flight-computer.kicad_pcb]
2024-12-28 Fixed disconnected 1V1 rails
    [flight-computer.kicad_pcb]
2024-12-30 Added battery charge monitor
    [flight-computer.kicad_pcb, power.kicad_sch]
2024-12-30 Added interrupt lines for IMU and magnetometer
    [flight-computer.kicad_pcb, flight-computer.kicad_sch, sensor-net.kicad_sch]
2024-12-30 Battery charge detection after reverse polarity protection for safety.
    [flight-computer.kicad_pcb, power.kicad_sch]
2024-12-31 Revamping docs, added SWD test pads.
    [flight-computer.kicad_pcb, flight-computer.kicad_sch]
2024-12-31 Changed LED resistors to 330 ohms to reduce brightness.
    [flight-computer.kicad_sch, power.kicad_sch, sensor-net.kicad_sch]
2024-12-31 Added MOSFET to drive the buzzer.
    [flight-computer.kicad_pcb, flight-computer.kicad_sch]
2025-01-01 Added keepout for patch antenna
    [flight-computer.kicad_pcb]
2025-01-01 Updated keepout to not keepout footprints to resolve DRC error becuase it was under the GPS
    [flight-computer.kicad_pcb]
2025-01-01 Made terminal block smaller.
    [flight-computer.kicad_pcb, power.kicad_sch]
2025-01-02 Removed some items from the paste layers, namely the SMA connector and USB throughole portions.
    [flight-computer.kicad_pcb]
2025-01-02 Drill files made.
    [flight-computer.kicad_pcb]
2025-01-02 Starting ground station design.
    [ground-station.kicad_pcb, ground-station.kicad_sch]
2025-01-02 Ignore gerber files
2025-01-02 Removed DRC errors on schematic by adding power flags.
    [flight-computer.kicad_sch, ground-station.kicad_sch, power.kicad_sch, radio.kicad_sch, sensor-net.kicad_sch]
2025-01-02 Created initial PCB layout for ground station.
    [ground-station.kicad_pcb, ground-station.kicad_sch]
2025-01-02 Modified paste layer
    [ground-station.kicad_pcb]
2025-01-02 Routing finished for ground station.
    [flight-computer.kicad_pcb, ground-station.kicad_pcb, ground-station.kicad_sch]
2025-01-02 Renamed directory to flight computer to differentiate from ground station
    [1726480102.step, AI-1223-TWT-3V-2-R.step, LSM6DSO32TR.step, MEM2067-02-180-00-A_REVB.step, flight-computer.kicad_pcb, flight-computer.kicad_sch, power.kicad_sch, radio.kicad_sch]
2025-01-02 Generated all gerbers for manufacture.
    [ground-station.kicad_pcb]
2025-01-02 Update README with better motivation and ground station image.
2025-01-02 BOMS exported and sorted.
    [ground-station.kicad_sch]
2025-01-02 Add image of ground station
2025-01-03 Update silkscreen to show reset pins.
    [flight-computer.kicad_pcb]
2025-01-03 Teardrop ground station.
    [ground-station.kicad_pcb]
2025-01-03 Remove out of stock LED from BOMS
    [flight-computer.kicad_sch, ground-station.kicad_sch, power.kicad_sch]
2025-01-04 Ground station enclosure prototype complete
    [Ground Station Enclosure.FCStd, ground-station.kicad_pcb, ground-station.step]
2025-01-08 Added step files necessary for enclosure assembly
    [Ground Station Enclosure.FCStd, M3x6mm_socket_head.step, ground-station.step]
2025-01-08 Start of enclosure
    [enclosure.FCStd]
2025-01-08 Added hinges.
    [enclosure.FCStd]
2025-01-08 Bottom of the case has finished shape.
    [enclosure.FCStd]
2025-01-08 Added holes for inserts
    [enclosure.FCStd]
2025-01-08 Added rough holes for SMA and USBC
    [enclosure.FCStd]
2025-01-08 Created initial assembly to verify fits.
    [M3x6mm_socket_head.step, assembly.FCStd, enclosure.FCStd]
2025-01-08 Added lid
    [enclosure.FCStd]
2025-01-09 Started replication of avionics bay in FreeCAD for others.
    [assembly.FCStd, enclosure.FCStd, flight-computer.kicad_pcb]
2025-01-09 Added flight computer on standoffs
    [assembly.FCStd]
2025-01-09 Sleds are now part of the assembly
    [assembly.FCStd, enclosure.FCStd]
2025-01-09 Added rails and sled screws
    [assembly.FCStd]
2025-01-09 Added hex nuts
    [assembly.FCStd]
2025-01-09 Fixed battery case holes
    [assembly.FCStd, enclosure.FCStd]
2025-01-09 Fix Pygmy rotation
    [assembly.FCStd]
2025-01-09 Added back hinges to lid.
    [enclosure.FCStd]
2025-01-09 Groove mate is complete
    [enclosure.FCStd]
2025-01-09 Added images of the enclosures.
    [assembly.FCStd, enclosure.FCStd]
2025-01-09 Added front hinges to the enclosure and re-rendered
    [assembly.FCStd, enclosure.FCStd]
2025-01-10 Added READMEs for enclosures and attribution to some inspirational resources.
    [assembly.FCStd, enclosure.FCStd]
2025-01-10 Added image of L1 assembly
2025-01-11 Add images of the manufactured board
2025-01-12 Updated to REV-B; KiCAD's default footprint (or at least first appearing) for the SMD crystal didn't match the datasheet and I didn't catch that. This was the only thing preventing me from booting an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
    [flight-computer.kicad_pcb, flight-computer.kicad_sch, power.kicad_sch, radio.kicad_sch, sensor-net.kicad_sch]
2025-01-12 Added silkscreen for magnetometer
    [flight-computer.kicad_pcb]
2025-01-12 Resolved all DRC issues.
    [flight-computer.kicad_pcb]
2025-01-12 Ordered part 2
    [flight-computer.kicad_pcb]
2025-01-12 Added buffer area for the antenna connector and USB-C connector so it is possible to attach the antenna and cable
    [assembly.FCStd, enclosure.FCStd]
2025-01-12 Heat set inserts now cut into the base more.
    [assembly.FCStd, enclosure.FCStd]
2025-01-23 Update to Pygmy Rev B
    [assembly.FCStd, enclosure.FCStd]
2025-03-23 Updated USB slot to be wider.
    [assembly.FCStd, enclosure.FCStd]
